yuvalkuck/smart-irrigate/hardware/kicad/mainboard/mainboard.kicad_sch

## KiCad design hardware/kicad/mainboard/mainboard.kicad_sch (2026-10-05, an earlier design)

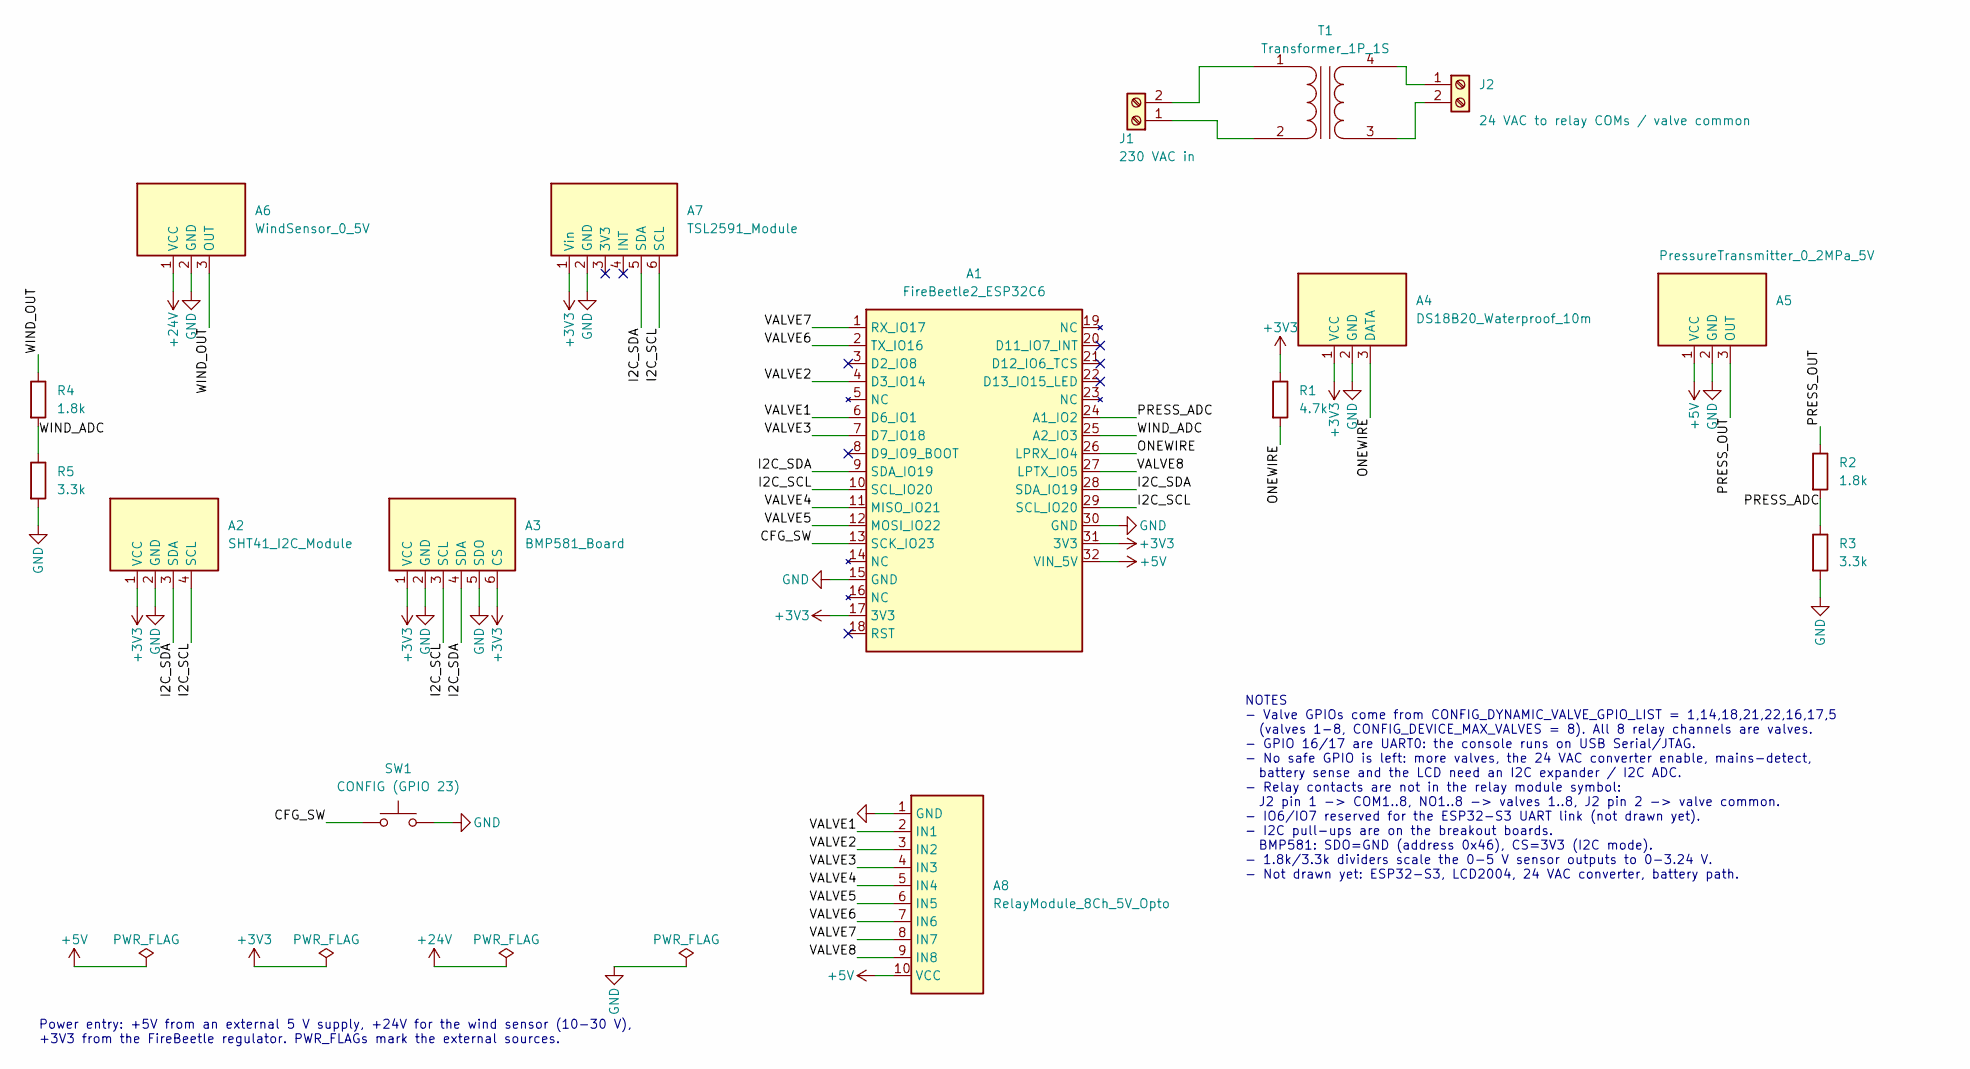
[picture p1: schematic mainboard.kicad_sch]

Parts:
A1: FireBeetle2_ESP32C6
A2: SHT41_I2C_Module
A3: BMP581_Board
A4: DS18B20_Waterproof_10m
A5: PressureTransmitter_0_2MPa_5V
A6: WindSensor_0_5V
A7: TSL2591_Module
A8: RelayModule_8Ch_5V_Opto
J1: 230 VAC in; TerminalBlock_Phoenix_MKDS-1,5-2_1x02_P5.00mm_Horizontal
J2: 24 VAC to relay COMs / valve common; TerminalBlock_Phoenix_MKDS-1,5-2_1x02_P5.00mm_Horizontal
R1: 4.7k; R_Axial_DIN0207_L6.3mm_D2.5mm_P7.62mm_Horizontal
R2, R4: 1.8k; R_Axial_DIN0207_L6.3mm_D2.5mm_P7.62mm_Horizontal
R3, R5: 3.3k; R_Axial_DIN0207_L6.3mm_D2.5mm_P7.62mm_Horizontal
SW1: CONFIG (GPIO 23); SW_PUSH_6mm
T1: Transformer_1P_1S

Connections:
+3V3: A1.17 (3V3), A1.31 (3V3), A2.1 (VCC), A3.1 (VCC), A3.6 (CS), A4.1 (VCC), A7.1 (Vin), R1.1
+5V: A1.32 (VIN_5V), A5.1 (VCC), A8.10 (VCC)
+24V: A6.1 (VCC)
CFG_SW: A1.13 (SCK_IO23), SW1.1
GND: A1.15 (GND), A1.30 (GND), A2.2 (GND), A3.2 (GND), A3.5 (SDO), A4.2 (GND), A5.2 (GND), A6.2 (GND), A7.2 (GND), A8.1 (GND), R3.2, R5.2, SW1.2
I2C_SCL: A1.10 (SCL_IO20), A1.29 (SCL_IO20), A2.4 (SCL), A3.3 (SCL), A7.6 (SCL)
I2C_SDA: A1.9 (SDA_IO19), A1.28 (SDA_IO19), A2.3 (SDA), A3.4 (SDA), A7.5 (SDA)
unnamed: J1.1, T1.2 (AB)
unnamed: J1.2, T1.1 (AA)
unnamed: J2.1, T1.4 (SB)
unnamed: J2.2, T1.3 (SA)
ONEWIRE: A1.26 (LPRX_IO4), A4.3 (DATA), R1.2
PRESS_ADC: A1.24 (A1_IO2), R2.2, R3.1
PRESS_OUT: A5.3 (OUT), R2.1
VALVE1: A1.6 (D6_IO1), A8.2 (IN1)
VALVE2: A1.4 (D3_IO14), A8.3 (IN2)
VALVE3: A1.7 (D7_IO18), A8.4 (IN3)
VALVE4: A1.11 (MISO_IO21), A8.5 (IN4)
VALVE5: A1.12 (MOSI_IO22), A8.6 (IN5)
VALVE6: A1.2 (TX_IO16), A8.7 (IN6)
VALVE7: A1.1 (RX_IO17), A8.8 (IN7)
VALVE8: A1.27 (LPTX_IO5), A8.9 (IN8)
WIND_ADC: A1.25 (A2_IO3), R4.2, R5.1
WIND_OUT: A6.3 (OUT), R4.1

Notes on the sheet:
Power entry: +5V from an external 5 V supply, +24V for the wind sensor (10-30 V), +3V3 from the FireBeetle regulator. PWR_FLAGs mark the external sources.
NOTES - Valve GPIOs come from CONFIG_DYNAMIC_VALVE_GPIO_LIST = 1,14,18,21,22,16,17,5 (valves 1-8, CONFIG_DEVICE_MAX_VALVES = 8). All 8 relay channels are valves. - GPIO 16/17 are UART0: the console runs on USB Serial/JTAG. - No safe GPIO is left: more valves, the 24 VAC converter enable, mains-dete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
