yuvalkuck/smart-irrigate/hardware/mainboard/mainboard.kicad_sch

## KiCad design hardware/mainboard/mainboard.kicad_sch (2026-11-13)

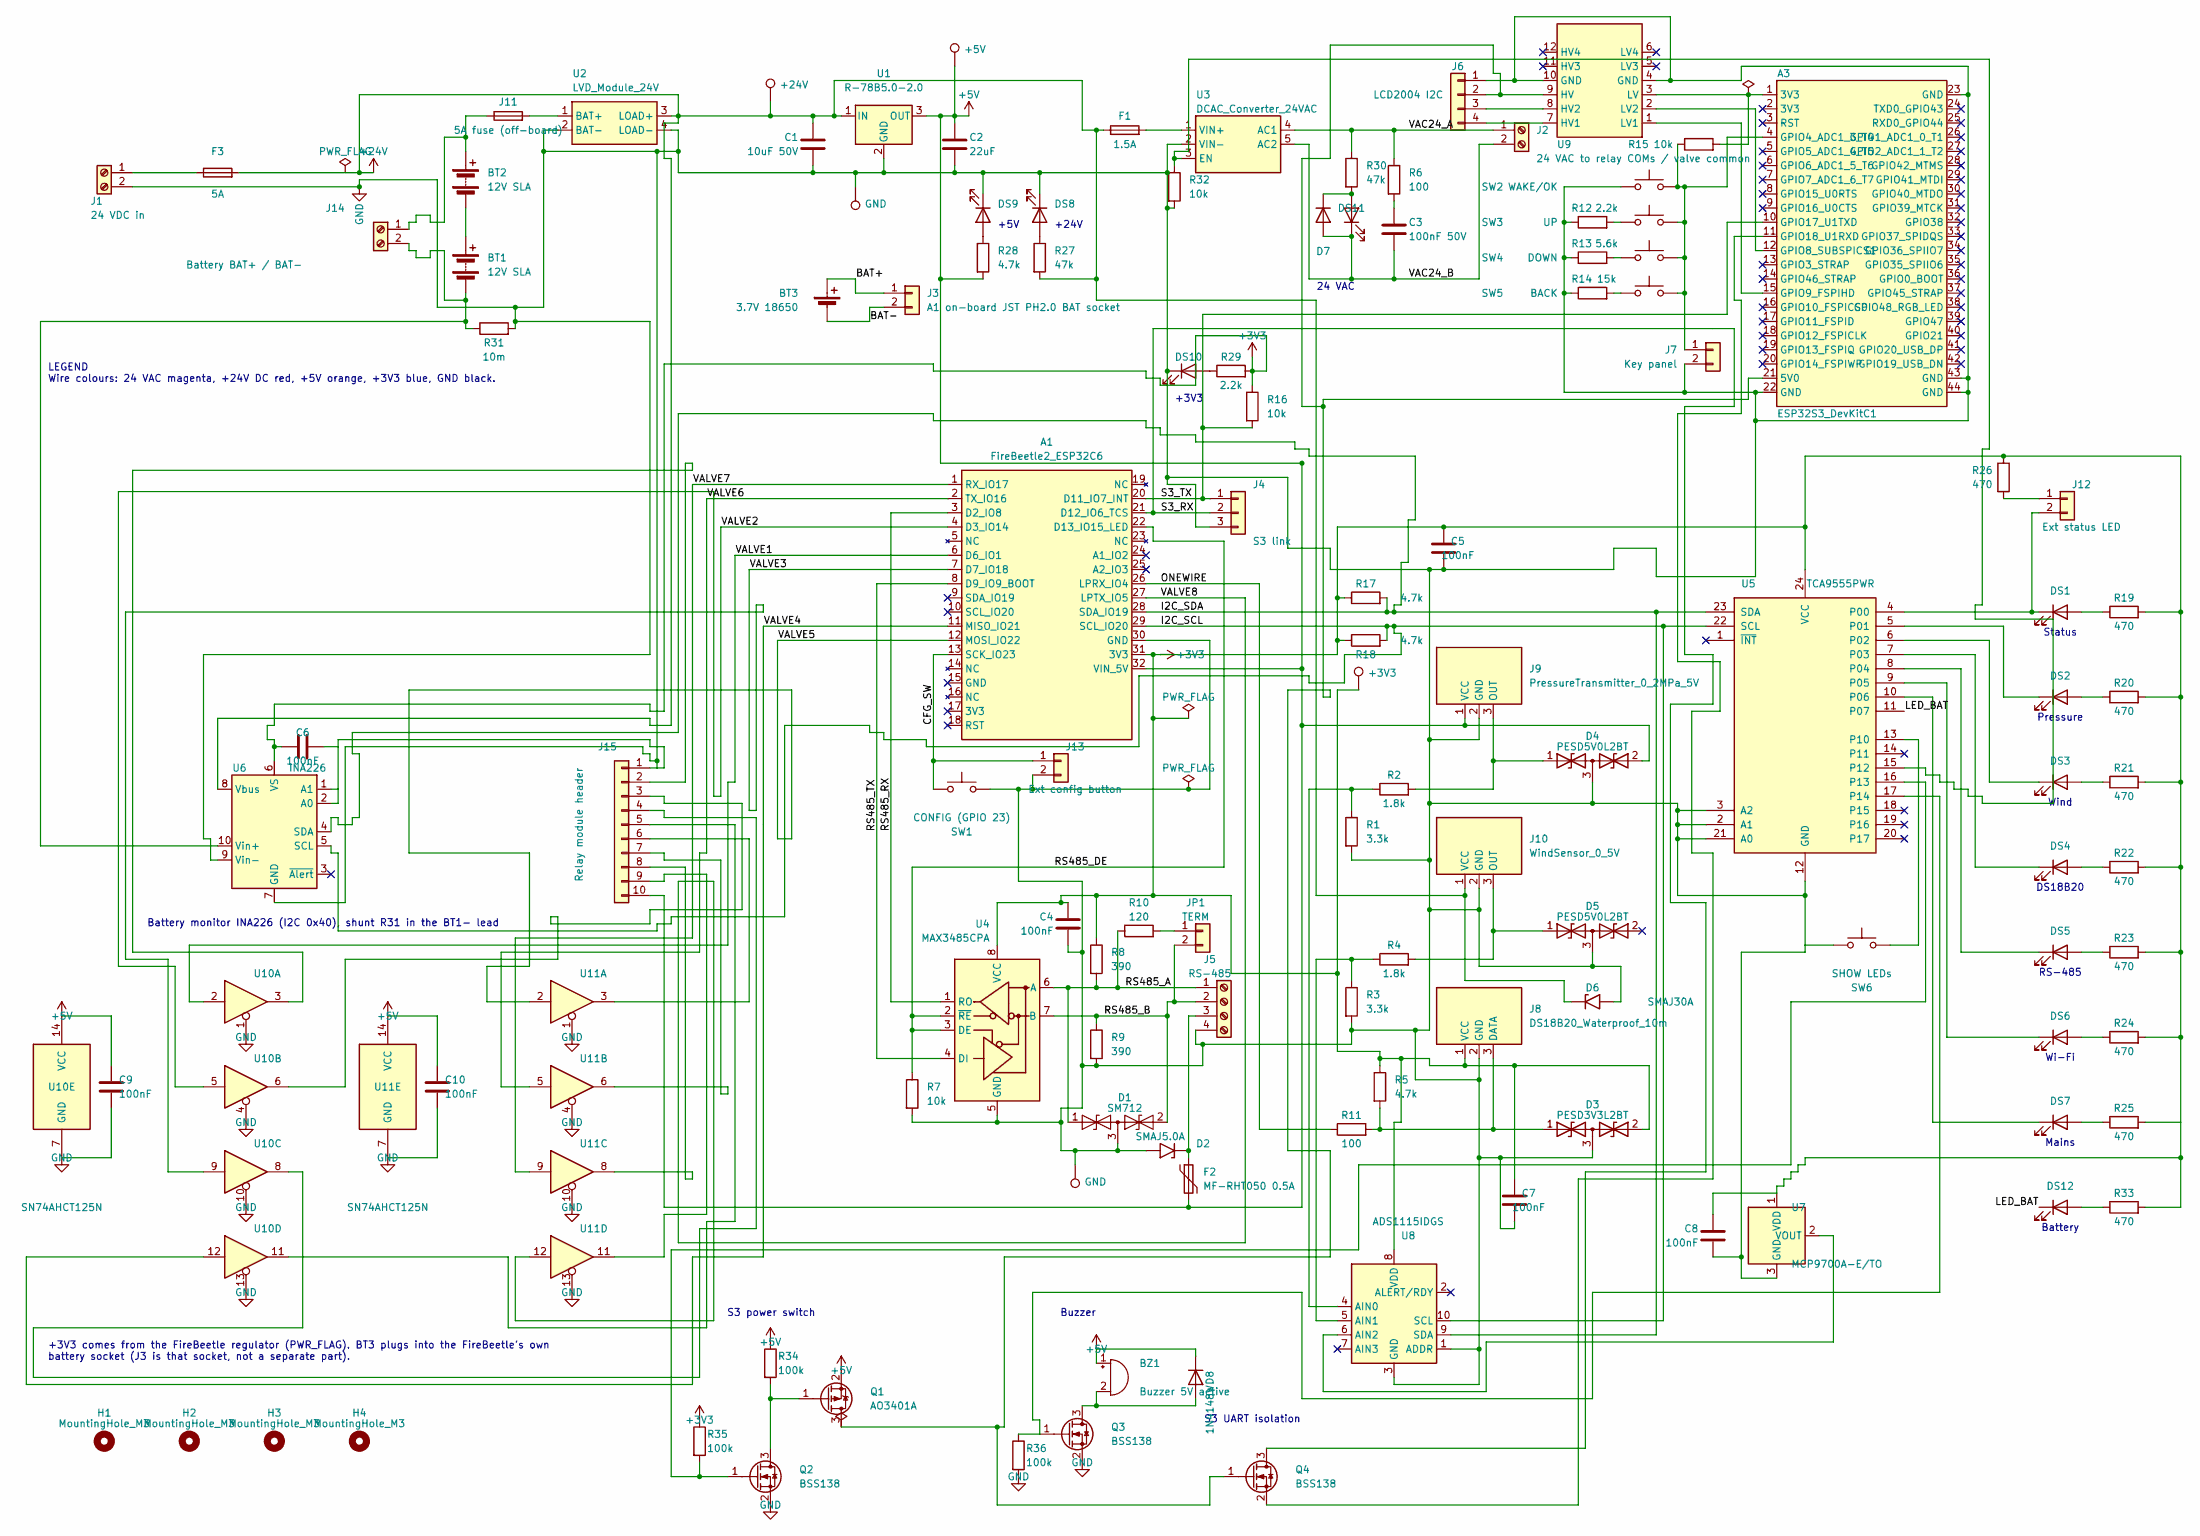
[picture p2: schematic mainboard.kicad_sch]

Parts:
A1: FireBeetle2_ESP32C6
A3: ESP32S3_DevKitC1
BT1, BT2: 12V SLA
BT3: 3.7V 18650
BZ1: Buzzer 5V active; Buzzer_12x9.5RM7.6
C1: 10uF 50V; CP_Radial_D6.3mm_P2.50mm
C2: 22uF; CP_Radial_D6.3mm_P2.50mm
C3: 100nF 50V; C_0805_2012Metric
C4, C5, C6, C7, C8, C9, C10: 100nF; C_0805_2012Metric
D1: SM712; SOT-23
D2: SMAJ5.0A; D_SMA
D3: PESD3V3L2BT; SOT-23
D4, D5: PESD5V0L2BT; SOT-23
D6: SMAJ30A; D_SMA
D7, D8: 1N4148W; D_SOD-123
DS1: LED 5mm green; LED_D5.0mm
DS2, DS3, DS4, DS5, DS6, DS7, DS12: LED 0805 green; LED_0805_2012Metric
DS8, DS9, DS10, DS11: LED 0805 red; LED_0805_2012Metric
F1: 1.5A; Fuseholder_TR5_Littelfuse_No560_No460
F2: MF-RHT050 0.5A; Fuse_Bourns_MF-RHT050
F3: 5A; FuseHolder_5x20_ELECAPITAL_PCB_Cover
H1, H2, H3, H4: MountingHole_M3; MountingHole_3.2mm_M3
J1: 24 VDC in; TerminalBlock_MaiXu_MX126-5.0-02P_1x02_P5.00mm
J2: 24 VAC to relay COMs / valve common; TerminalBlock_MaiXu_MX126-5.0-02P_1x02_P5.00mm
J3: A1 on-board JST PH2.0 BAT socket
J4: S3 link; PinHeader_1x03_P2.54mm_Vertical
J5: RS-485; PinHeader_1x04_P2.54mm_Vertical
J6: LCD2004 I2C; PinHeader_1x04_P2.54mm_Vertical
J7: Key panel; PinHeader_1x02_P2.54mm_Vertical
J8: DS18B20_Waterproof_10m; PinHeader_1x03_P2.54mm_Vertical
J9: PressureTransmitter_0_2MPa_5V; PinHeader_1x03_P2.54mm_Vertical
J10: WindSensor_0_5V; TerminalBlock_MaiXu_MX126-5.0-04P_1x04_P5.00mm
J11: 5A fuse (off-board); TerminalBlock_MaiXu_MX126-5.0-02P_1x02_P5.00mm
J12: Ext status LED; PinHeader_1x02_P2.54mm_Vertical
J13: Ext config button; PinHeader_1x02_P2.54mm_Vertical
J14: Battery BAT+ / BAT-; TerminalBlock_MaiXu_MX126-5.0-02P_1x02_P5.00mm
J15: Relay module header; PinHeader_1x10_P2.54mm_Vertical
JP1: TERM; PinHeader_1x02_P2.54mm_Vertical
Q1: AO3401A; SOT-23
Q2, Q3, Q4: BSS138; SOT-23
R1, R3: 3.3k; R_0805_2012Metric
R2, R4: 1.8k; R_0805_2012Metric
R5, R17, R18, R28: 4.7k; R_0805_2012Metric
R6, R11: 100; R_0805_2012Metric
R7, R15, R16, R32: 10k; R_0805_2012Metric
R8, R9: 390; R_0805_2012Metric
R10: 120; R_0805_2012Metric
R12, R29: 2.2k; R_0805_2012Metric
R13: 5.6k; R_0805_2012Metric
R14: 15k; R_0805_2012Metric
R19, R20, R21, R22, R23, R24, R25, R26, R33: 470; R_0805_2012Metric
R27, R30: 47k; R_0805_2012Metric
R31: 10m; R_2512_6332Metric
R34, R35, R36: 100k; R_0805_2012Metric
SW1: CONFIG (GPIO 23); SW_Tactile_6x6x5_2pin
SW2: WAKE/OK; SW_PUSH_6mm
SW3: UP; SW_PUSH_6mm
SW4: DOWN; SW_PUSH_6mm
SW5: BACK; SW_PUSH_6mm
SW6: SHOW LEDs; SW_Tactile_6x6x5_2pin
TP1: +24V; TestPoint_THTPad_D2.0mm_Drill1.0mm
TP2: +5V; TestPoint_THTPad_D2.0mm_Drill1.0mm
TP3: +3V3; TestPoint_THTPad_D2.0mm_Drill1.0mm
TP4, TP5: GND; TestPoint_THTPad_D2.0mm_Drill1.0mm
U1: R-78B5.0-2.0; Converter_DCDC_RECOM_R-78B-2.0_THT
U2: LVD_Module_24V
U3: DCAC_Converter_24VAC
U4: MAX3485CPA; DIP-8_W7.62mm
U5: TCA9555PWR; TSSOP-24_4.4x7.8mm_P0.65mm
U6: INA226; MSOP-10_3x3mm_P0.5mm
U7: MCP9700A-E/TO; TO-92_Inline
U8: ADS1115IDGS; TSSOP-10_3x3mm_P0.5mm
U9: LogicLevelConverter_BSS138_4ch
U10, U11: SN74AHCT125N; DIP-14_W7.62mm

Connections:
+3V3: A1.31 (3V3), C4.1, C5.1, C6.1, C7.1, C8.1, D3.2 (A2), J8.1 (VCC), R5.1, R8.1, R16.1, R17.1, R18.1, R19.2, R20.2, R21.2, R22.2, R23.2, R24.2, R25.2, R26.1, R29.2, R33.2, R35.1, TP3.1, U4.8 (VCC), U5.24 (VCC), U6.6 (VS), U7.1 (VDD), U8.8 (VDD)
+5V: A1.32 (VIN_5V), BZ1.1 (+), C2.1, C9.1, C10.1, D4.2 (A2), D8.1 (K), F2.2, J9.1 (VCC), J15.10, Q1.2 (S), R28.2, R34.1, TP2.1, U1.3 (OUT), U10.14 (VCC), U11.14 (VCC)
+24V: C1.1, D6.1 (A1), F1.1, F3.2, J10.1 (VCC), R27.2, TP1.1, U1.1 (IN), U2.3 (LOAD+), U6.8 (Vbus)
BAT+: BT3.1 (+), J3.1
BAT-: BT3.2 (-), J3.2
CFG_SW: A1.13 (SCK_IO23), J13.1, SW1.1
GND: A1.30 (GND), A3.22 (GND), A3.23 (GND), A3.43 (GND), A3.44 (GND), C1.2, C2.2, C4.2, C5.2, C6.2, C7.2, C8.2, C9.2, C10.2, D1.3 (common), D2.2 (A2), D3.3 (common), D4.3 (common), D5.3 (common), D6.2 (A2), DS8.1 (K), DS9.1 (K), DS10.1 (K), J1.2, J4.3, J5.4, J6.1, J7.2, J8.2 (GND), J9.2 (GND), J10.2 (GND), J13.2, J15.1, Q2.2 (S), Q3.2 (S), R1.2, R3.2, R7.2, R9.2, R12.1, R13.1, R14.1, R31.2, R32.2, R36.2, SW1.2, SW2.1, SW6.1, TP4.1, TP5.1, U1.2 (GND), U2.2 (BAT-), U2.4 (LOAD-), U3.2 (VIN-), U4.5 (GND), U5.2 (A1), U5.3 (A2), U5.12 (GND), U5.21 (A0), U6.1 (A1), U6.2 (A0), U6.7 (GND), U6.9 (Vin-), U7.3 (GND), U8.1 (ADDR), U8.3 (GND), U9.4 (GND), U9.10 (GND), U10.1, U10.4, U10.7 (GND), U10.10, U10.13, U11.1, U11.4, U11.7 (GND), U11.10, U11.13
I2C_SCL: A1.29 (SCL_IO20), R18.2, U5.22 (SCL), U6.5 (SCL), U8.10 (SCL)
I2C_SDA: A1.28 (SDA_IO19), R17.2, U5.23 (SDA), U6.4 (SDA), U8.9 (SDA)
LED_BAT: DS12.1 (K), U5.11 (P07)
unnamed: A3.1 (3V3), R15.2, U9.3 (LV)
unnamed: A3.4 (GPIO4_ADC1_3_T4), J7.1, R15.1, SW2.2, SW3.2, SW4.2, SW5.2
unnamed: A3.11 (GPIO18_U1RXD), Q4.2 (S)
unnamed: A3.12 (GPIO8_SUBSPICS1), U9.2 (LV2)
unnamed: A3.15 (GPIO9_FSPIHD), U9.1 (LV1)
unnamed: A3.21 (5V0), J6.2, Q1.3 (D), Q4.1 (G), U9.9 (HV)
unnamed: BT1.1 (+), BT2.2 (-)
unnamed: BT1.2 (-), J14.2, R31.1, U6.10 (Vin+)
unnamed: BT2.1 (+), J11.1, J14.1
unnamed: BZ1.2 (-), D8.2 (A), Q3.3 (D)
unnamed: C3.1, R6.2
unnamed: D2.1 (A1), F2.1, J5.3
unnamed: D3.1 (A1), J8.3 (DATA), R5.2, R11.2
unnamed: D4.1 (A1), J9.3 (OUT), R2.2
unnamed: D5.1 (A1), J10.3 (OUT), R4.2
unnamed: D7.1 (K), DS11.2 (A), R30.2
unnamed: DS1.1 (K), J12.2, U5.4 (P00)
unnamed: DS1.2 (A), R19.1
unnamed: DS2.1 (K), U5.5 (P01)
unnamed: DS2.2 (A), R20.1
unnamed: DS3.1 (K), U5.6 (P02)
unnamed: DS3.2 (A), R21.1
unnamed: DS4.1 (K), U5.7 (P03)
unnamed: DS4.2 (A), R22.1
unnamed: DS5.1 (K), U5.8 (P04)
unnamed: DS5.2 (A), R23.1
unnamed: DS6.1 (K), U5.9 (P05)
unnamed: DS6.2 (A), R24.1
unnamed: DS7.1 (K), U5.10 (P06)
unnamed: DS7.2 (A), R25.1
unnamed: DS8.2 (A), R27.1
unnamed: DS9.2 (A), R28.1
unnamed: DS10.2 (A), R29.1
unnamed: DS12.2 (A), R33.1
unnamed: F1.2, U3.1 (VIN+)
unnamed: F3.1, J1.1
unnamed: J6.3, U9.8 (HV2)
unnamed: J6.4, U9.7 (HV1)
unnamed: J11.2, U2.1 (BAT+)
unnamed: J12.1, R26.2
unnamed: J15.2, U10.3
unnamed: J15.3, U10.6
unnamed: J15.4, U10.8
unnamed: J15.5, U10.11
unnamed: J15.6, U11.3
unnamed: J15.7, U11.6
unnamed: J15.8, U11.8
unnamed: J15.9, U11.11
unnamed: JP1.1, R10.2
unnamed: Q1.1 (G), Q2.3 (D), R34.2
unnamed: Q2.1 (G), R35.2, U5.16 (P13)
unnamed: Q3.1 (G), R36.1, U5.17 (P14)
unnamed: R1.1, R2.1, U8.4 (AIN0)
unnamed: R3.1, R4.1, U8.5 (AIN1)
unnamed: R12.2, SW3.1
unnamed: R13.2, SW4.1
unnamed: R14.2, SW5.1
unnamed: R32.1, U3.3 (EN), U5.15 (P12)
unnamed: SW6.2, U5.13 (P10)
unnamed: U7.2 (VOUT), U8.6 (AIN2)
ONEWIRE: A1.26 (LPRX_IO4), R11.1
RS485_A: D1.1 (A1), J5.1, R8.2, R10.1, U4.6 (A)
RS485_B: D1.2 (A2), J5.2, JP1.2, R9.1, U4.7 (B)
RS485_DE: A1.22 (D13_IO15_LED), R7.1, U4.2 (~RE), U4.3 (DE)
RS485_RX: A1.3 (D2_IO8), U4.1 (RO)
RS485_TX: A1.8 (D9_IO9_BOOT), U4.4 (DI)
S3_RX: A1.21 (D12_IO6_TCS), J4.2, Q4.3 (D)
S3_TX: A1.20 (D11_IO7_INT), A3.10 (GPIO17_U1TXD), J4.1, R16.2
VAC24_A: J2.1, R6.1, R30.1, U3.4 (AC1)
VAC24_B: C3.2, D7.2 (A), DS11.1 (K), J2.2, U3.5 (AC2)
VALVE1: A1.6 (D6_IO1), U10.2
VALVE2: A1.4 (D3_IO14), U10.5
VALVE3: A1.7 (D7_IO18), U10.9
VALVE4: A1.11 (MISO_IO21), U10.12
VALVE5: A1.12 (MOSI_IO22), U11.2
VALVE6: A1.2 (TX_IO16), U11.5
VALVE7: A1.1 (RX_IO17), U11.9
VALVE8: A1.27 (LPTX_IO5), U11.12

Notes on the sheet:
+5V
+24V
Mains
Wind
Battery monitor INA226 (I2C 0x40), shunt R31 in the BT1- lead
+3V3 comes from the FireBeetle regulator (PWR_FLAG). BT3 plugs into the FireBeetle's own battery socket (J3 is that socket, not a separate part).
+3V3
24 VAC
DS18B20
LEGEND Wire colours: 24 VAC magenta, +24V DC red, +5V orange, +3V3 blue, GND black.
Pressure
RS-485
Wi-Fi
Status
Battery
S3 power switch
Buzzer
S3 UART isolation
