yuvalkuck/smart-irrigate/hardware/sensor-cluster/sensor-cluster.kicad_sch

## KiCad design hardware/sensor-cluster/sensor-cluster.kicad_sch (2026-11-08)

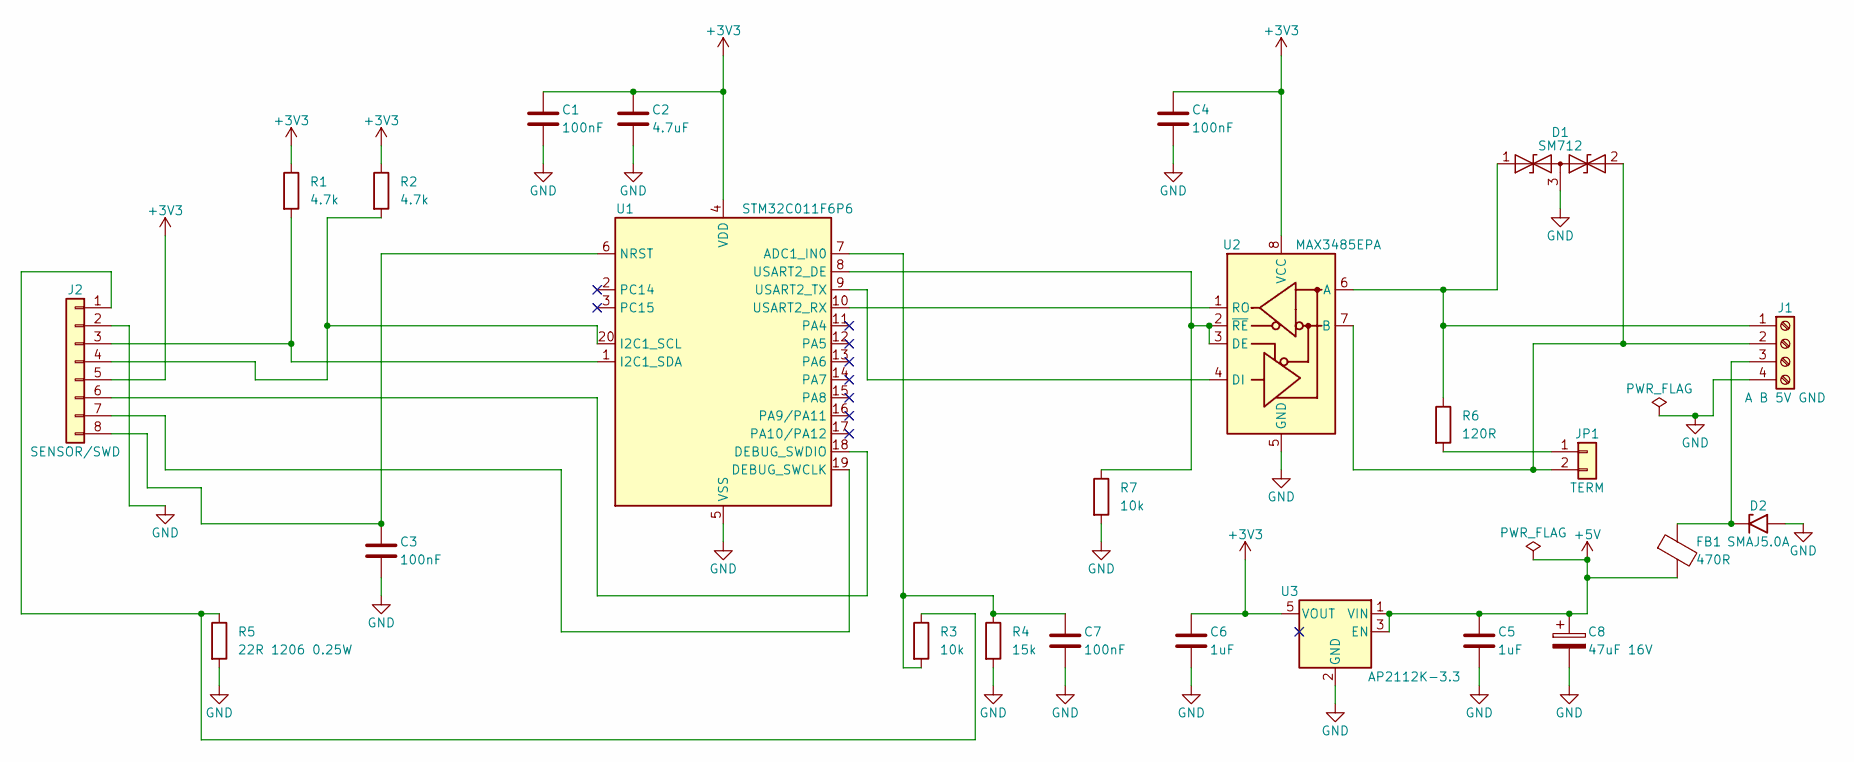
[picture p3: schematic sensor-cluster.kicad_sch]

Parts:
C1, C3, C4, C7: 100nF; C_0805_2012Metric
C2: 4.7uF; C_0805_2012Metric
C5, C6: 1uF; C_0805_2012Metric
C8: 47uF 16V; CP_Radial_D5.0mm_P2.00mm
D1: SM712; SOT-23
D2: SMAJ5.0A; D_SMA
FB1: 470R; L_0805_2012Metric
J1: A B 5V GND; TerminalBlock_Phoenix_MKDS-1,5-4_1x04_P5.00mm_Horizontal
J2: SENSOR/SWD; PinHeader_1x08_P2.54mm_Vertical
JP1: TERM; PinHeader_1x02_P2.54mm_Vertical
R1, R2: 4.7k; R_0805_2012Metric
R3, R7: 10k; R_0805_2012Metric
R4: 15k; R_0805_2012Metric
R5: 22R 1206 0.25W; R_1206_3216Metric
R6: 120R; R_0805_2012Metric
U1: STM32C011F6P6; TSSOP-20_4.4x6.5mm_P0.65mm
U2: MAX3485EPA; DIP-8_W7.62mm
U3: AP2112K-3.3; SOT-23-5

Connections:
+3V3: C1.1, C2.1, C4.1, C6.1, J2.5, R1.1, R2.1, U1.4 (VDD), U2.8 (VCC), U3.5 (VOUT)
+5V: C5.1, C8.1, FB1.2, U3.1 (VIN), U3.3 (EN)
GND: C1.2, C2.2, C3.2, C4.2, C5.2, C6.2, C7.2, C8.2, D1.3 (common), D2.2 (A2), J1.4, J2.2, R4.2, R5.2, R7.2, U1.5 (VSS), U2.5 (GND), U3.2 (GND)
unnamed: C3.1, J2.8, U1.6 (PF2)
unnamed: C7.1, R3.2, R4.1, U1.7 (PA0)
unnamed: D1.1 (A1), J1.1, R6.1, U2.6 (A)
unnamed: D1.2 (A2), J1.2, JP1.2, U2.7 (B)
unnamed: D2.1 (A1), FB1.1, J1.3
unnamed: J2.1, R3.1, R5.1
unnamed: J2.3, R1.2, U1.1 (PB7)
unnamed: J2.4, R2.2, U1.20 (PB6)
unnamed: J2.6, U1.18 (PA13)
unnamed: J2.7, U1.19 (PA14)
unnamed: JP1.1, R6.2
unnamed: R7.1, U1.8 (PA1), U2.2 (~RE), U2.3 (DE)
unnamed: U1.9 (PA2), U2.4 (DI)
unnamed: U1.10 (PA3), U2.1 (RO)
