yuvalkuck/smart-irrigate/components/telemetry/inc/sensor_bmp5xx.h

//
// Created by uv on 12/08/2026.
//

#ifndef SMART_IRRIGATE_BMP5XX_SENSOR_H
#define SMART_IRRIGATE_BMP5XX_SENSOR_H
#include "sensor_concept.h"
class SensorBMP5xx : public AbstractSensorI2C<SensorBMP5xx> {
    public:
    esp_err_t init(i2c_master_bus_handle_t);
    bool read(TelemetryData& );
    bool online(i2c_master_bus_handle_t);
};

#endif //SMART_IRRIGATE_BMP5XX_SENSOR_H
