yuvalkuck/smart-irrigate/components/telemetry/inc/sensor_xdb401.h

//
// Created by uv on 16/08/2026.
//

#ifndef SMART_IRRIGATE_SENSOR_XDB401_H
#define SMART_IRRIGATE_SENSOR_XDB401_H
#include "sensor_concept.h"
class SensorXDB4xx : public AbstractSensorADC<SensorXDB4xx> {
    public:
    esp_err_t init(adc_oneshot_unit_handle_t);
    bool read(TelemetryData &);
    bool online(adc_oneshot_unit_handle_t);
};

#endif //SMART_IRRIGATE_SENSOR_XDB401_H
