yuvalkuck/smart-irrigate/(commit log)

2026-04-20 have start mqtt after time sync, still n ot stl connection
2026-05-03 load correct but not advaitize
    [partitions.csv]
2026-05-05 enable BLE
    [partitions.csv]
2026-05-27 add telemetry component
    [partitions.csv]
2026-05-28 try to create and read/write from seperate nvs partition
    [partitions.csv]
2026-05-30 store correctly NVS partition
    [partitions.csv]
2026-05-31 fix wrong load of nvs_config
    [entrypoint.cpp]
2026-06-01 use C++ for NvsConfig handler Container
    [partitions.csv]
2026-06-10 add excomm component for configuration interpreter
    [partitions.csv]
2026-06-15 add getConfiguration as DMA access
    [configuration.h, partitions.csv]
2026-06-15 add setConfiguration to save mqtt event
    [configuration.h]
2026-06-16 add config generator for standard set.
    [configuration.h]
2026-06-18 add COMMON_EVENT_ACCEPT_SERVER_CONFIGURATION handle
    [partitions.csv]
2026-06-21 move app event handler to seperate source file
    [partitions.csv]
2026-06-21 optimized & cleanup
    [partitions.csv]
2026-06-22 AI refactoring with human care
    [configuration.h]
2026-07-05 replace bme680 with sht41
    [event_handler.cpp, telemetry.cpp]
2026-08-06 remove BLE support. update project scope of sensors.
2026-08-07 add wind analog sensor
2026-08-08 start to intigrate ADC with exist sensors
2026-08-09 remove overhead adc init
2026-08-09 add drivers for other sensors as possible
2026-08-09 add method trace logger
2026-08-09 integrate as match as possible of the coming sensors ...
2026-08-10 add device name insted of BT name
2026-08-18 add all sensors code
2026-08-22 fix collision in valves default GPIOs and the DFRobot FireBeetle2 ESP32-C6
2026-08-22 fix comments data content
    [event_handler.cpp, sensor_bmp5xx.cpp, sensor_ds18b20.cpp, sensor_sht4x.cpp, sensor_tsl2591.cpp, sensor_wind.cpp, sensor_xdb401.cpp]
2026-10-04 add power design
2026-10-05 expand configuration to 8 valves
2026-10-05 add kicad schema for now
    [mainboard.kicad_pcb, mainboard.kicad_sch]
2026-10-05 connect what it needed
    [mainboard.kicad_sch]
2026-10-05 connect the Power
    [mainboard.kicad_sch]
2026-10-05 add reserved for S3
    [mainboard.kicad_sch]
2026-11-08 add table of sensors
2026-11-08 add sensors platform
2026-11-09 split to fit modules model, & elecrit schematic
2026-11-13 add 2 SN74ahct125N chips to 5V relay array. validate board integrity.
